monotech/PC104-SVGA/README.md

Schematic based on Sergey Kiselev's ISA SVGA schematic. http://www.malinov.com/Home/sergeys-projects/isa-supervga
