monotech/PC104-SVGA/isa_svga.kicad_pcb

## KiCad design isa_svga.kicad_pcb (2020-01-08)

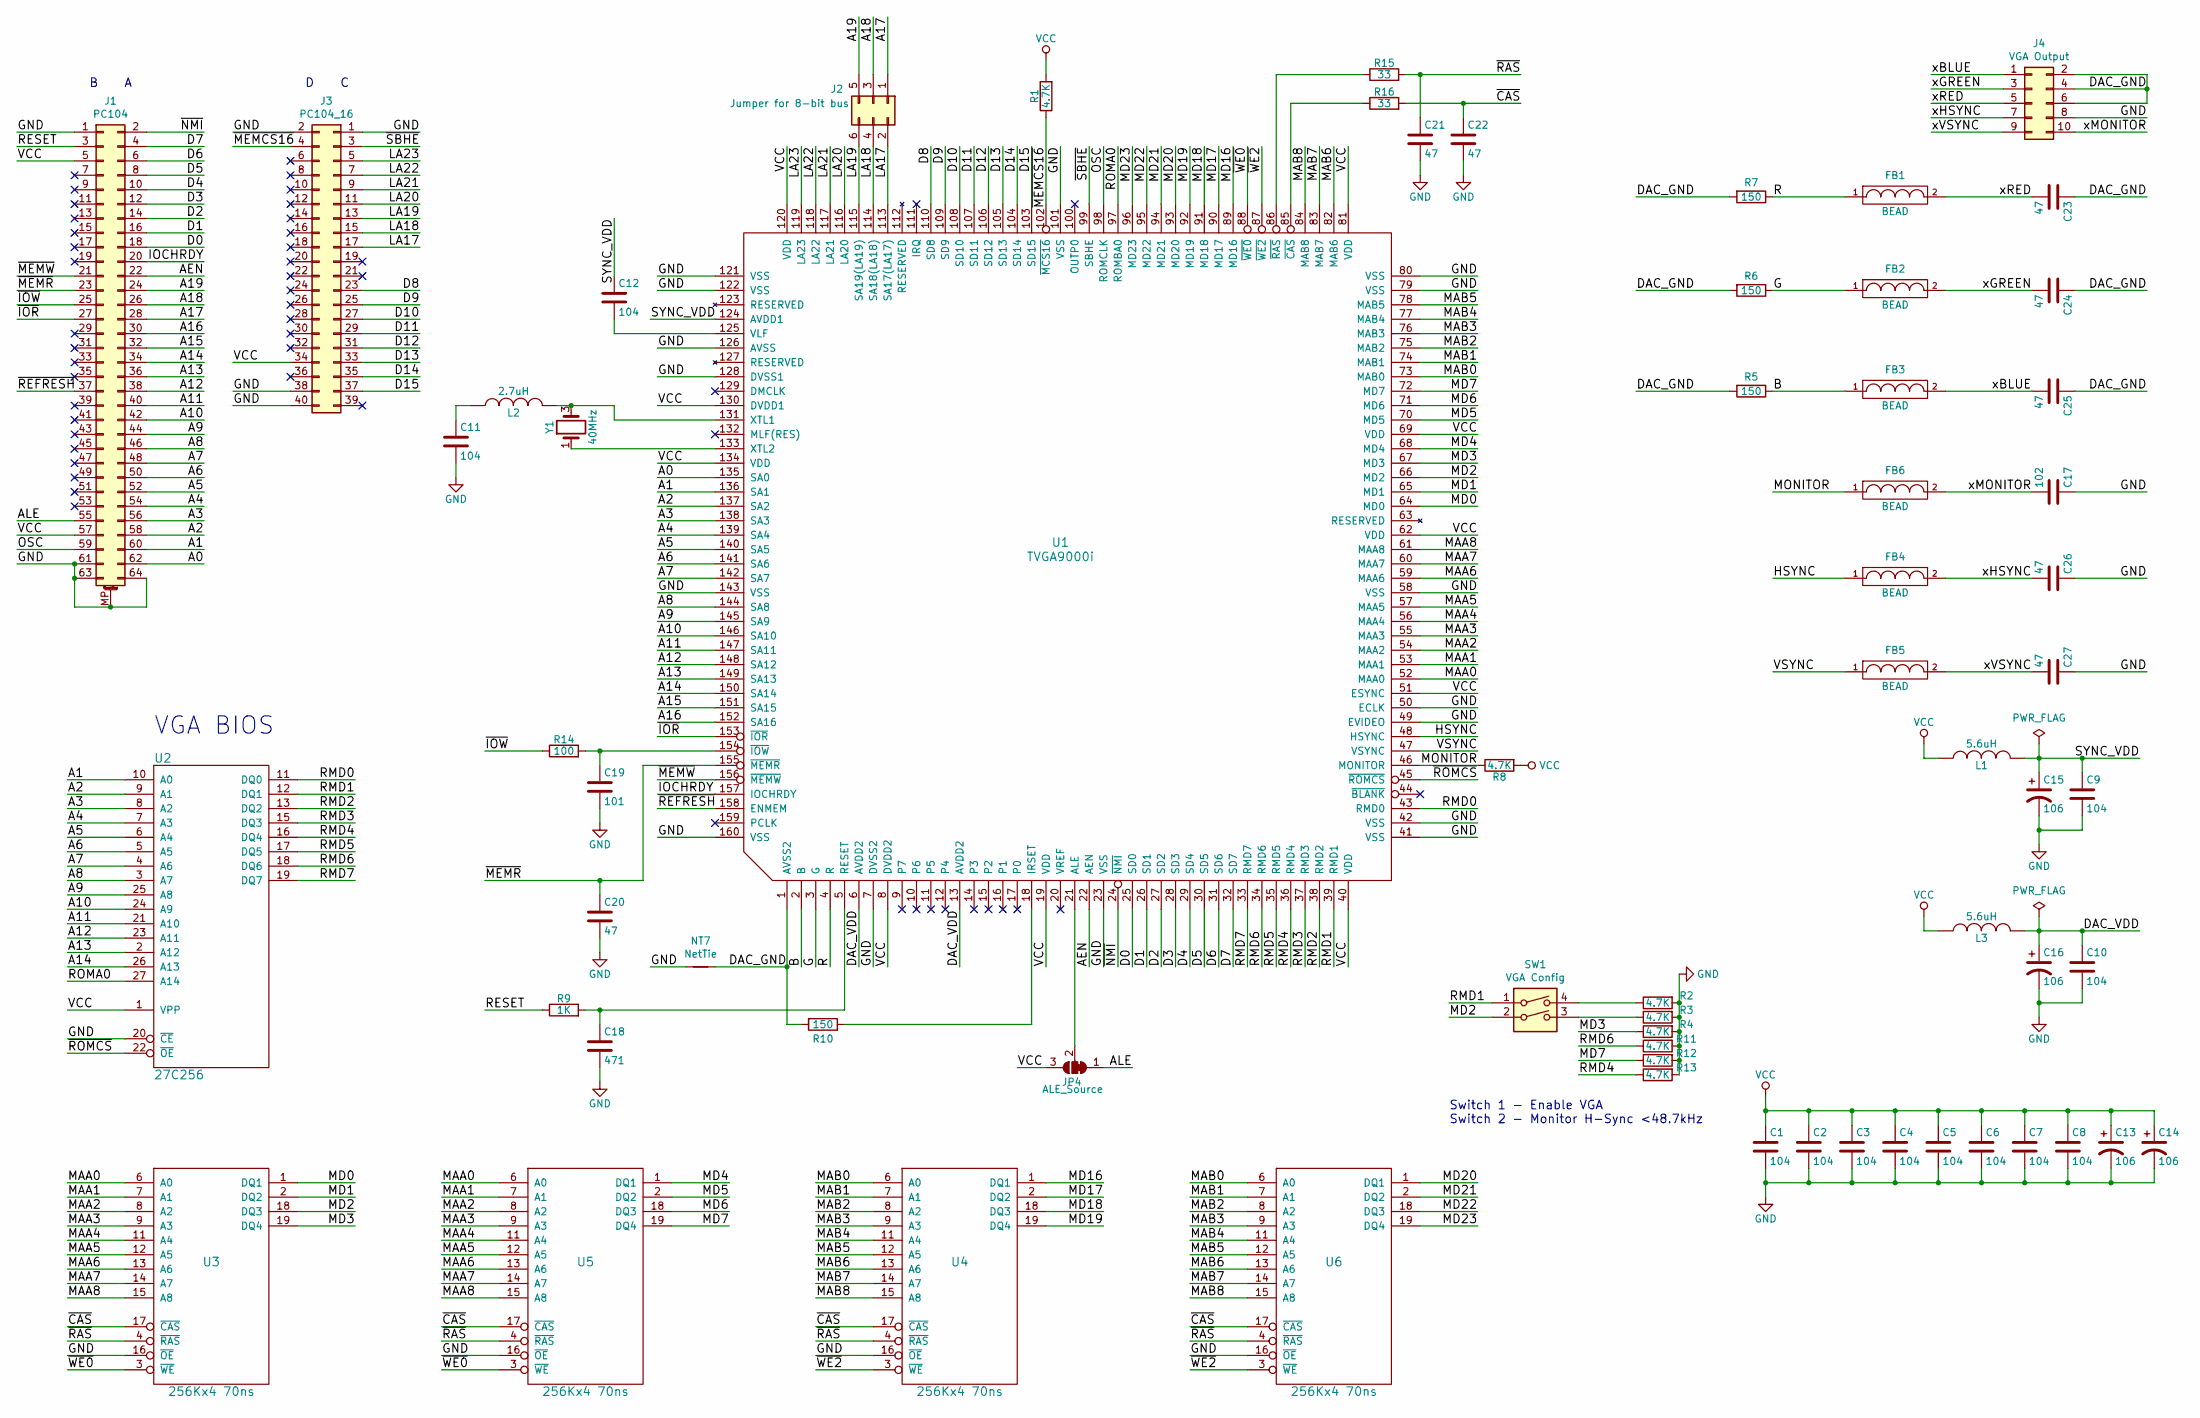
[picture p1: schematic isa_svga.sch, PC/104 SVGA]

Parts:
C1, C2, C3, C4, C5, C6, C7, C8, C9, C10, C11, C12: 104; C_0603_1608Metric
C13, C14, C15, C16: 106; C_0603_1608Metric
C17: 102; C_0805_2012Metric
C18: 471; C_0805_2012Metric
C19: 101; C_0805_2012Metric
C20, C21, C22, C23, C24, C25, C26, C27: 47; C_0603_1608Metric
FB1, FB2, FB3, FB4, FB5, FB6: BEAD; C_0805_2012Metric
J1: PC104; PC104_Platform
J2: Jumper for 8-bit bus; Triple-bridged-jumper
J3: PC104_16; PinSocket_2x20_P2.54mm_Vertical
J4: VGA Output; IDC-Header_2x05_P2.54mm_Horizontal
JP4: ALE_Source; SolderJumper-3_P1.3mm_Bridged12_Pad1.0x1.5mm
L1, L3: 5.6uH; C_0805_2012Metric
L2: 2.7uH; C_0805_2012Metric
NT7: NetTie; NetTie-2_SMD_Pad0.5mm
R1, R2, R3, R4, R8, R11, R12, R13: 4.7K; R_0805_2012Metric
R5, R6, R7, R10: 150; R_0805_2012Metric
R9: 1K; R_0805_2012Metric
R14: 100; R_0805_2012Metric
R15, R16: 33; R_0805_2012Metric
SW1: VGA Config; SW_DIP_SPSTx02_Slide_9.78x7.26mm_W7.62mm_P2.54mm
U1: TVGA9000i; PQFP-160_28x28mm_P0.65mm_LongPads
U2: 27C256; DIP-28_W15.24mm_Socket
U3, U4, U5, U6: 256Kx4 70ns; DIP-20_W7.62mm_Socket
Y1: 40MHz; Oscillator_SMD_Abracon_ASE-4Pin_3.2x2.5mm

Connections:
/A0: J1.62, U1.135 (SA0)
/A1: J1.60, U1.136 (SA1), U2.10 (A0)
/A2: J1.58, U1.137 (SA2), U2.9 (A1)
/A3: J1.56, U1.138 (SA3), U2.8 (A2)
/A4: J1.54, U1.139 (SA4), U2.7 (A3)
/A5: J1.52, U1.140 (SA5), U2.6 (A4)
/A6: J1.50, U1.141 (SA6), U2.5 (A5)
/A7: J1.48, U1.142 (SA7), U2.4 (A6)
/A8: J1.46, U1.144 (SA8), U2.3 (A7)
/A9: J1.44, U1.145 (SA9), U2.25 (A8)
/A10: J1.42, U1.146 (SA10), U2.24 (A9)
/A11: J1.40, U1.147 (SA11), U2.21 (A10)
/A12: J1.38, U1.148 (SA12), U2.23 (A11)
/A13: J1.36, U1.149 (SA13), U2.2 (A12)
/A14: J1.34, U1.150 (SA14), U2.26 (A13)
/A15: J1.32, U1.151 (SA15)
/A16: J1.30, U1.152 (SA16)
/A17: J1.28, J2.1
/A18: J1.26, J2.3
/A19: J1.24, J2.5
/AEN: J1.22, U1.22 (AEN)
/ALE: J1.55, JP4.1 (A)
/B: FB3.1, R5.1, U1.2 (B)
/D0: J1.18, U1.25 (SD0)
/D1: J1.16, U1.26 (SD1)
/D2: J1.14, U1.27 (SD2)
/D3: J1.12, U1.28 (SD3)
/D4: J1.10, U1.29 (SD4)
/D5: J1.8, U1.30 (SD5)
/D6: J1.6, U1.31 (SD6)
/D7: J1.4, U1.32 (SD7)
/D8: J3.23, U1.110 (SD8)
/D9: J3.25, U1.109 (SD9)
/D10: J3.27, U1.108 (SD10)
/D11: J3.29, U1.107 (SD11)
/D12: J3.31, U1.106 (SD12)
/D13: J3.33, U1.105 (SD13)
/D14: J3.35, U1.104 (SD14)
/D15: J3.37, U1.103 (SD15)
/DAC_GND: C23.1, C24.1, C25.1, J4.2, J4.4, J4.6, NT7.2, R5.2, R6.2, R7.2, R10.2, U1.1 (AVSS2)
/DAC_VDD: C10.1, C16.1, L3.2, U1.6 (AVDD2), U1.13 (AVDD2)
/G: FB2.1, R6.1, U1.3 (G)
/HSYNC: FB4.1, U1.48 (HSYNC)
/IOCHRDY: J1.20, U1.157 (IOCHRDY)
/LA17: J2.2, J3.17, U1.113 (SA17(LA17))
/LA18: J2.4, J3.15, U1.114 (SA18(LA18))
/LA19: J2.6, J3.13, U1.115 (SA19(LA19))
/LA20: J3.11, U1.116 (LA20)
/LA21: J3.9, U1.117 (LA21)
/LA22: J3.7, U1.118 (LA22)
/LA23: J3.5, U1.119 (LA23)
/MAA0: U1.52 (MAA0), U3.6 (A0), U5.6 (A0)
/MAA1: U1.53 (MAA1), U3.7 (A1), U5.7 (A1)
/MAA2: U1.54 (MAA2), U3.8 (A2), U5.8 (A2)
/MAA3: U1.55 (MAA3), U3.9 (A3), U5.9 (A3)
/MAA4: U1.56 (MAA4), U3.11 (A4), U5.11 (A4)
/MAA5: U1.57 (MAA5), U3.12 (A5), U5.12 (A5)
/MAA6: U1.59 (MAA6), U3.13 (A6), U5.13 (A6)
/MAA7: U1.60 (MAA7), U3.14 (A7), U5.14 (A7)
/MAA8: U1.61 (MAA8), U3.15 (A8), U5.15 (A8)
/MAB0: U1.73 (MAB0), U4.6 (A0), U6.6 (A0)
/MAB1: U1.74 (MAB1), U4.7 (A1), U6.7 (A1)
/MAB2: U1.75 (MAB2), U4.8 (A2), U6.8 (A2)
/MAB3: U1.76 (MAB3), U4.9 (A3), U6.9 (A3)
/MAB4: U1.77 (MAB4), U4.11 (A4), U6.11 (A4)
/MAB5: U1.78 (MAB5), U4.12 (A5), U6.12 (A5)
/MAB6: U1.82 (MAB6), U4.13 (A6), U6.13 (A6)
/MAB7: U1.83 (MAB7), U4.14 (A7), U6.14 (A7)
/MAB8: U1.84 (MAB8), U4.15 (A8), U6.15 (A8)
/MD0: U1.64 (MD0), U3.1 (DQ1)
/MD1: U1.65 (MD1), U3.2 (DQ2)
/MD2: SW1.2, U1.66 (MD2), U3.18 (DQ3)
/MD3: R4.1, U1.67 (MD3), U3.19 (DQ4)
/MD4: U1.68 (MD4), U5.1 (DQ1)
/MD5: U1.70 (MD5), U5.2 (DQ2)
/MD6: U1.71 (MD6), U5.18 (DQ3)
/MD7: R12.1, U1.72 (MD7), U5.19 (DQ4)
/MD16: U1.89 (MD16), U4.1 (DQ1)
/MD17: U1.90 (MD17), U4.2 (DQ2)
/MD18: U1.91 (MD18), U4.18 (DQ3)
/MD19: U1.92 (MD19), U4.19 (DQ4)
/MD20: U1.93 (MD20), U6.1 (DQ1)
/MD21: U1.94 (MD21), U6.2 (DQ2)
/MD22: U1.95 (MD22), U6.18 (DQ3)
/MD23: U1.96 (MD23), U6.19 (DQ4)
/MONITOR: FB6.1, R8.1, U1.46 (MONITOR)
/OSC: J1.59, U1.98 (ROMCLK)
/R: FB1.1, R7.1, U1.4 (R)
/RESET: J1.3, R9.1
/RMD0: U1.43 (RMD0), U2.11 (DQ0)
/RMD1: SW1.1, U1.39 (RMD1), U2.12 (DQ1)
/RMD2: U1.38 (RMD2), U2.13 (DQ2)
/RMD3: U1.37 (RMD3), U2.15 (DQ3)
/RMD4: R13.1, U1.36 (RMD4), U2.16 (DQ4)
/RMD5: U1.35 (RMD5), U2.17 (DQ5)
/RMD6: R11.1, U1.34 (RMD6), U2.18 (DQ6)
/RMD7: U1.33 (RMD7), U2.19 (DQ7)
/ROMA0: U1.97 (ROMBA0), U2.27 (A14)
/SYNC_VDD: C9.1, C12.1, C15.1, L1.2, U1.124 (AVDD1)
/VSYNC: FB5.1, U1.47 (VSYNC)
/xBLUE: C25.2, FB3.2, J4.1
/xGREEN: C24.2, FB2.2, J4.3
/xHSYNC: C26.2, FB4.2, J4.7
/xMONITOR: C17.2, FB6.2, J4.10
/xRED: C23.2, FB1.2, J4.5
/xVSYNC: C27.2, FB5.2, J4.9
/~CAS: C22.1, R16.2, U3.17 (~CAS), U4.17 (~CAS), U5.17 (~CAS), U6.17 (~CAS)
/~IOR: J1.27, U1.153 (~IOR)
/~IOW: J1.25, R14.1
/~MEMCS16: J3.4, R1.1, U1.102 (~MCS16)
/~MEMR: C20.1, J1.23, U1.155 (~MEMR)
/~MEMW: J1.21, U1.156 (~MEMW)
/~NMI: J1.2, U1.24 (~NMI)
/~RAS: C21.1, R15.2, U3.4 (~RAS), U4.4 (~RAS), U5.4 (~RAS), U6.4 (~RAS)
/~REFRESH: J1.37, U1.158 (ENMEM)
/~ROMCS: U1.45 (~ROMCS), U2.22 (~OE)
/~SBHE: J3.3, U1.99 (SBHE)
/~WE0: U1.88 (~WE0), U3.3 (~WE), U5.3 (~WE)
/~WE2: U1.87 (~WE2), U4.3 (~WE), U6.3 (~WE)
GND: C1.2, C2.2, C3.2, C4.2, C5.2, C6.2, C7.2, C8.2, C9.2, C10.2, C11.2, C13.2, C14.2, C15.2, C16.2, C17.1, C18.2, C19.2, C20.2, C21.2, C22.2, C26.1, C27.1, J1.1, J1.61, J1.63, J1.64, J1.MP (MountPin), J3.1, J3.2, J3.38, J3.40, J4.8, NT7.1, R2.2, R3.2, R4.2, R11.2, R12.2, R13.2, U1.7 (DVSS2), U1.23 (VSS), U1.41 (VSS), U1.42 (VSS), U1.49 (EVIDEO), U1.50 (ECLK), U1.58 (VSS), U1.79 (VSS), U1.80 (VSS), U1.101 (VSS), U1.121 (VSS), U1.122 (VSS), U1.126 (AVSS), U1.128 (DVSS1), U1.143 (VSS), U1.160 (VSS), U2.14 (GND), U2.20 (~CE), U3.16 (~OE), U3.20 (GND), U4.16 (~OE), U4.20 (GND), U5.16 (~OE), U5.20 (GND), U6.16 (~OE), U6.20 (GND)
unnamed: C11.1, L2.1
unnamed: C12.2, U1.125 (VLF)
unnamed: C18.1, R9.2, U1.5 (RESET)
unnamed: C19.1, R14.2, U1.154 (~IOW)
unnamed: JP4.2 (C), U1.21 (ALE)
unnamed: L2.2, U1.131 (XTL1), Y1.3
unnamed: R2.1, SW1.4
unnamed: R3.1, SW1.3
unnamed: R10.1, U1.18 (IRSET)
unnamed: R15.1, U1.86 (~RAS)
unnamed: R16.1, U1.85 (~CAS)
unnamed: U1.133 (XTL2), Y1.1
VCC: C1.1, C2.1, C3.1, C4.1, C5.1, C6.1, C7.1, C8.1, C13.1, C14.1, J1.5, J1.57, J3.34, JP4.3 (B), L1.1, L3.1, R1.2, R8.2, U1.8 (DVDD2), U1.19 (VDD), U1.40 (VDD), U1.51 (ESYNC), U1.62 (VDD), U1.69 (VDD), U1.81 (VDD), U1.120 (VDD), U1.130 (DVDD1), U1.134 (VDD), U2.1 (VPP), U2.28 (VCC), U3.10 (VCC), U4.10 (VCC), U5.10 (VCC), U6.10 (VCC)

Notes on the sheet:
VGA BIOS
Switch 1 - Enable VGA Switch 2 - Monitor H-Sync <48.7kHz
B A
D C

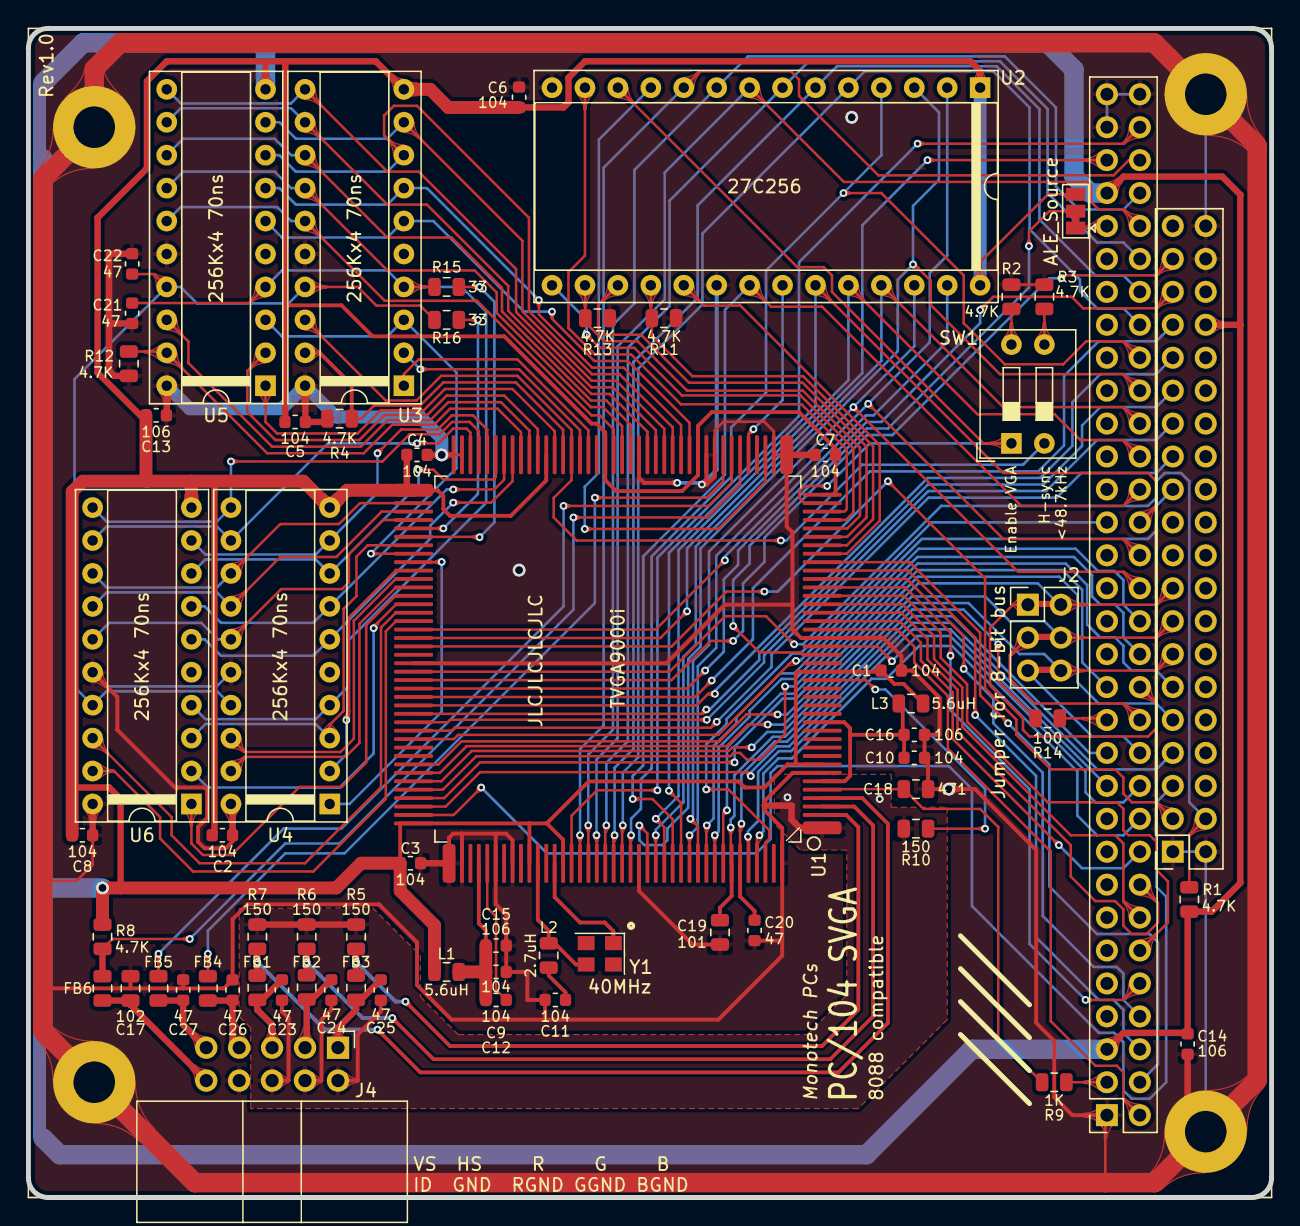
[picture p2: board isa_svga.kicad_pcb from above]

Board: 2 copper layers, 95.9 x 90.2 mm, 66 parts (0 on the bottom side), 133 nets.
