monotech/PC104-SVGA/(threads)

Thread 1 (2023-02-01):

Jumpers J2 are connected on PCB

72ka, 2023-02-01:
Hi, on the PCB the J2 jumper is always shortened. So it is always switched to 8bit BUS. I tooks me days to find this issue where this card didnt work on my PC104 CPU board. After removing the three lines, my card finally works.
Thank you for this project.
